KoljaWindeler/CHIP_relay/quotations/quotation_assumtions_v3_20160816jkw.xlsx

Sheet: total
 |  |  |  |  | Customer address | Elecrow address
Vendor:Elecrow |  | Customer: |  |  | Kolja Windeler, Muehlenstr 8a, 29342 Wienhausen, Germany | 5 Floor F1 Building, Fanshen Hua Feng Industrial Park, Hangcheng Road, Gushu, Bao'an District, Shenzhen, 518126 China Tel: +86 0755 36948521
Contact Person:Zeqing |  | Contact Person:
Tel:+86 185 6676 0765 |  | Tel:
Email:Zeqing2012@elecrow.com |  | Email:
Shipping methodDHL |  | Date: 2016/7
If there is any problem, please feel free to contact with me.
For PCB fabricate
Name | layers | dimension | Thickness | surface finished | Solder Mask | Qty | Quotation（$) | weight(g) | Remark
v100_mini | 2 |  | 1.6 | hasl | black | 30 | $27.80
Stencil |  |  |  |  |  |  | $18.00
 |  |  |  |  |  | Total:
For PCB Assembly
Name | Pads | quatity | price | qty of boards | Quotation | Remark
v48 | SMT | 78 | 0.030 | 30 | $125.40 | no discount
 | THT | 46 | 0.040
 |  |  |  | Total:
Engineer Start
Total: | $10.00
Components purchased by Eelcrow |  | Remark
Total: | $44.10 | 30
Shipping
Products | Shipping Method | Weight | Quotation | Remark
PCBAs | DHL | 1kg | $29.00
 |  | Total:
 |  |  |  |  | Total Quatation($): | 8.5 | per board
 |  |  |  |  |  | 254.3 | 30

Sheet: V48
Bill of Material from queso_dip_v4_8.sch, 50 parts, grouped by values, as of 2016/7/13 16:06:16
Part | Value | Device | Package | Description | unit price | total | unit smd | total smd | unit tht | total tht | Qty
R11 | 10k | R-EU_R0805 | R0805 | RESISTOR, European symbol | 0.01 | 0.01 | 2 | 2 | 0 | 0 | 1
R7 | 120R | R-EU_R0805 | R0805 | RESISTOR, European symbol | 0.01 | 0.01 | 2 | 2 | 0 | 0 | 1
POW | 150080BS75000 | LEDCHIP-LED0805 | CHIP-LED0805 | LED |  | 0 | 2 | 2 | 0 | 0 | 1
R1 | 2.2k | R-EU_R0805 | R0805 | RESISTOR, European symbol | 0.01 | 0.01 | 2 | 2 | 0 | 0 | 1
R2, R3, R4, R5 | 200R | R-EU_R0805 | R0805 | RESISTOR, European symbol | 0.01 | 0.04 | 2 | 8 | 0 | 0 | 4
JP1, JP2, JP3 | 571-4-103321-5 | MA03-1 | MA03-1 | PIN HEADER |  | 0 | 0 | 0 | 3 | 9 | 3
SV3 | 571-4-146262-1 | MA03-2 | MA03-2 | PIN HEADER |  | 0 | 0 | 0 | 6 | 6 | 1
SV4 | 649-68000-408HLF | MA08-1 | MA08-1 | PIN HEADER |  | 0 | 0 | 0 | 8 | 8 | 1
P1, P2, P3, P4 | 696-SML-0805ICTR | LEDCHIP-LED0805 | CHIP-LED0805 | LED |  | 0 | 2 | 8 | 0 | 0 | 4
IC1 | 74HCT04D | 74HCT04D | SO14 | Hex INVERTER |  | 0 | 14 | 14 | 0 | 0 | 1
B1 | DBLS202G | DBLS202G | DBS | Single Phase 1.0 AMP Glass Passivated Bridge Rectifier |  | 0 | 4 | 4 | 0 | 0 | 1
U$3, U$7, U$9, U$12 | DMN6068SE-13 | NMOSFET_SMD_223 | SOT223 |  |  | 0 | 4 | 16 | 0 | 0 | 4
U1 | DS2431P+T&R | DS2431P | TSOC6 | 1024-Bit EEPROM |  | 0 | 6 | 6 | 0 | 0 | 1
C2, C4, C5 | EMZR500ADA221MHA0G | CPOL-US150CLZ-0810 | 150CLZ-0810 | POLARIZED CAPACITOR, American symbol |  | 0 | 2 | 6 | 0 | 0 | 3
D1, D2, D3, D4 | ES2D | DIODE-SMB | SMB | DIODE | 0.35 | 1.4 | 2 | 8 | 0 | 0 | 4
U$10 | R-7805-1.0 | R-7805-1.0 | SIP3 |  |  | 0 | 0 | 0 | 3 | 3 | 1
U$1, U$2, U$8, U$11 | SRD-05VDC-SL-C | RELAYPTH | SRD-05VDC-SL-C | SPDT relay (COM-00101) |  | 0 | 0 | 0 | 5 | 20 | 4
R6, R8, R9, R10 | n.a. (10k) | R-EU_R0805 | R0805 | RESISTOR, European symbol
 |  |  |  |  | total | 1.47 |  | 78 |  | 46
 |  |  |  |  | ordered like this before or confirmed
 |  |  |  |  | never order, price check
 |  |  |  |  | do not assemble

Sheet: Sheet1
Parts | Value | Device | Package | Description | Qty | DESCRIPTION | FOOTPRINT | LINK | MF | MFG | MFG_PN | MPN | OC_FARNELL | OC_NEWARK | PART_TYPE | PRICE | PROD_ID | TOLLERANCE | VENDOR | VENDOR_PART_NUMBER
R11 | 10k | R-EU_R0805 | R0805 | RESISTOR, European symbol | 1
R7 | 120R | R-EU_R0805 | R0805 | RESISTOR, European symbol | 1
POW | 150080BS75000 | LEDCHIP-LED0805 | CHIP-LED0805 | LED | 1
R1 | 2.2k | R-EU_R0805 | R0805 | RESISTOR, European symbol | 1
R2, R3, R4, R5 | 200R | R-EU_R0805 | R0805 | RESISTOR, European symbol | 4
JP1, JP2, JP3 | 571-4-103321-5 | MA03-1 | MA03-1 | PIN HEADER | 3 |  |  |  |  |  |  |  | unknown | unknown
SV3 | 571-4-146262-1 | MA03-2 | MA03-2 | PIN HEADER | 1 |  |  |  |  |  |  |  | unknown | unknown
SV4 | 649-68000-408HLF | MA08-1 | MA08-1 | PIN HEADER | 1 |  |  |  |  |  |  |  | unknown | unknown
P1, P2, P3, P4 | 696-SML-0805ICTR | LEDCHIP-LED0805 | CHIP-LED0805 | LED | 4
IC1 | 74HCT04D | 74HCT04D | SO14 | Hex INVERTER | 1
B1 | DBLS202G | DBLS202G | DBS | Single Phase 1.0 AMP Glass Passivated Bridge Rectifier | 1
U$3, U$7, U$9, U$12 | DMN6068SE-13 | NMOSFET_SMD_223 | SOT223 |  | 4
U1 | DS2431P+T&R | DS2431P | TSOC6 | 1024-Bit EEPROM | 1 | IC, 1024-Bit, 1-Wire EEPROM, TSOC6 | TSOC6 | http://www.digikey.com/product-detail/en/DS2431P%2BT%26R/DS2431P%2BT%26RCT-ND/3647900 |  | DIGIKEY | DS2431P+T&RCT-ND |  |  |  | IC | 0.98 |  |  | MAXIM | DS2431P+T&R
C2, C4, C5 | EMZR500ADA221MHA0G | CPOL-US150CLZ-0810 | 150CLZ-0810 | POLARIZED CAPACITOR, American symbol | 3
D1, D2, D3, D4 | ES2D | DIODE-SMB | SMB | DIODE | 4
U$10 | R-7805-1.0 | R-7805-1.0 | SIP3 |  | 1
U$1, U$2, U$8, U$11 | SRD-05VDC-SL-C | RELAYPTH | SRD-05VDC-SL-C | SPDT relay (COM-00101) | 4
