KoljaWindeler/CHIP_relay/schematics/v3/relay_dip_v03.brd

## EAGLE design schematics/v3/relay_dip_v03.brd (2017-02-10)

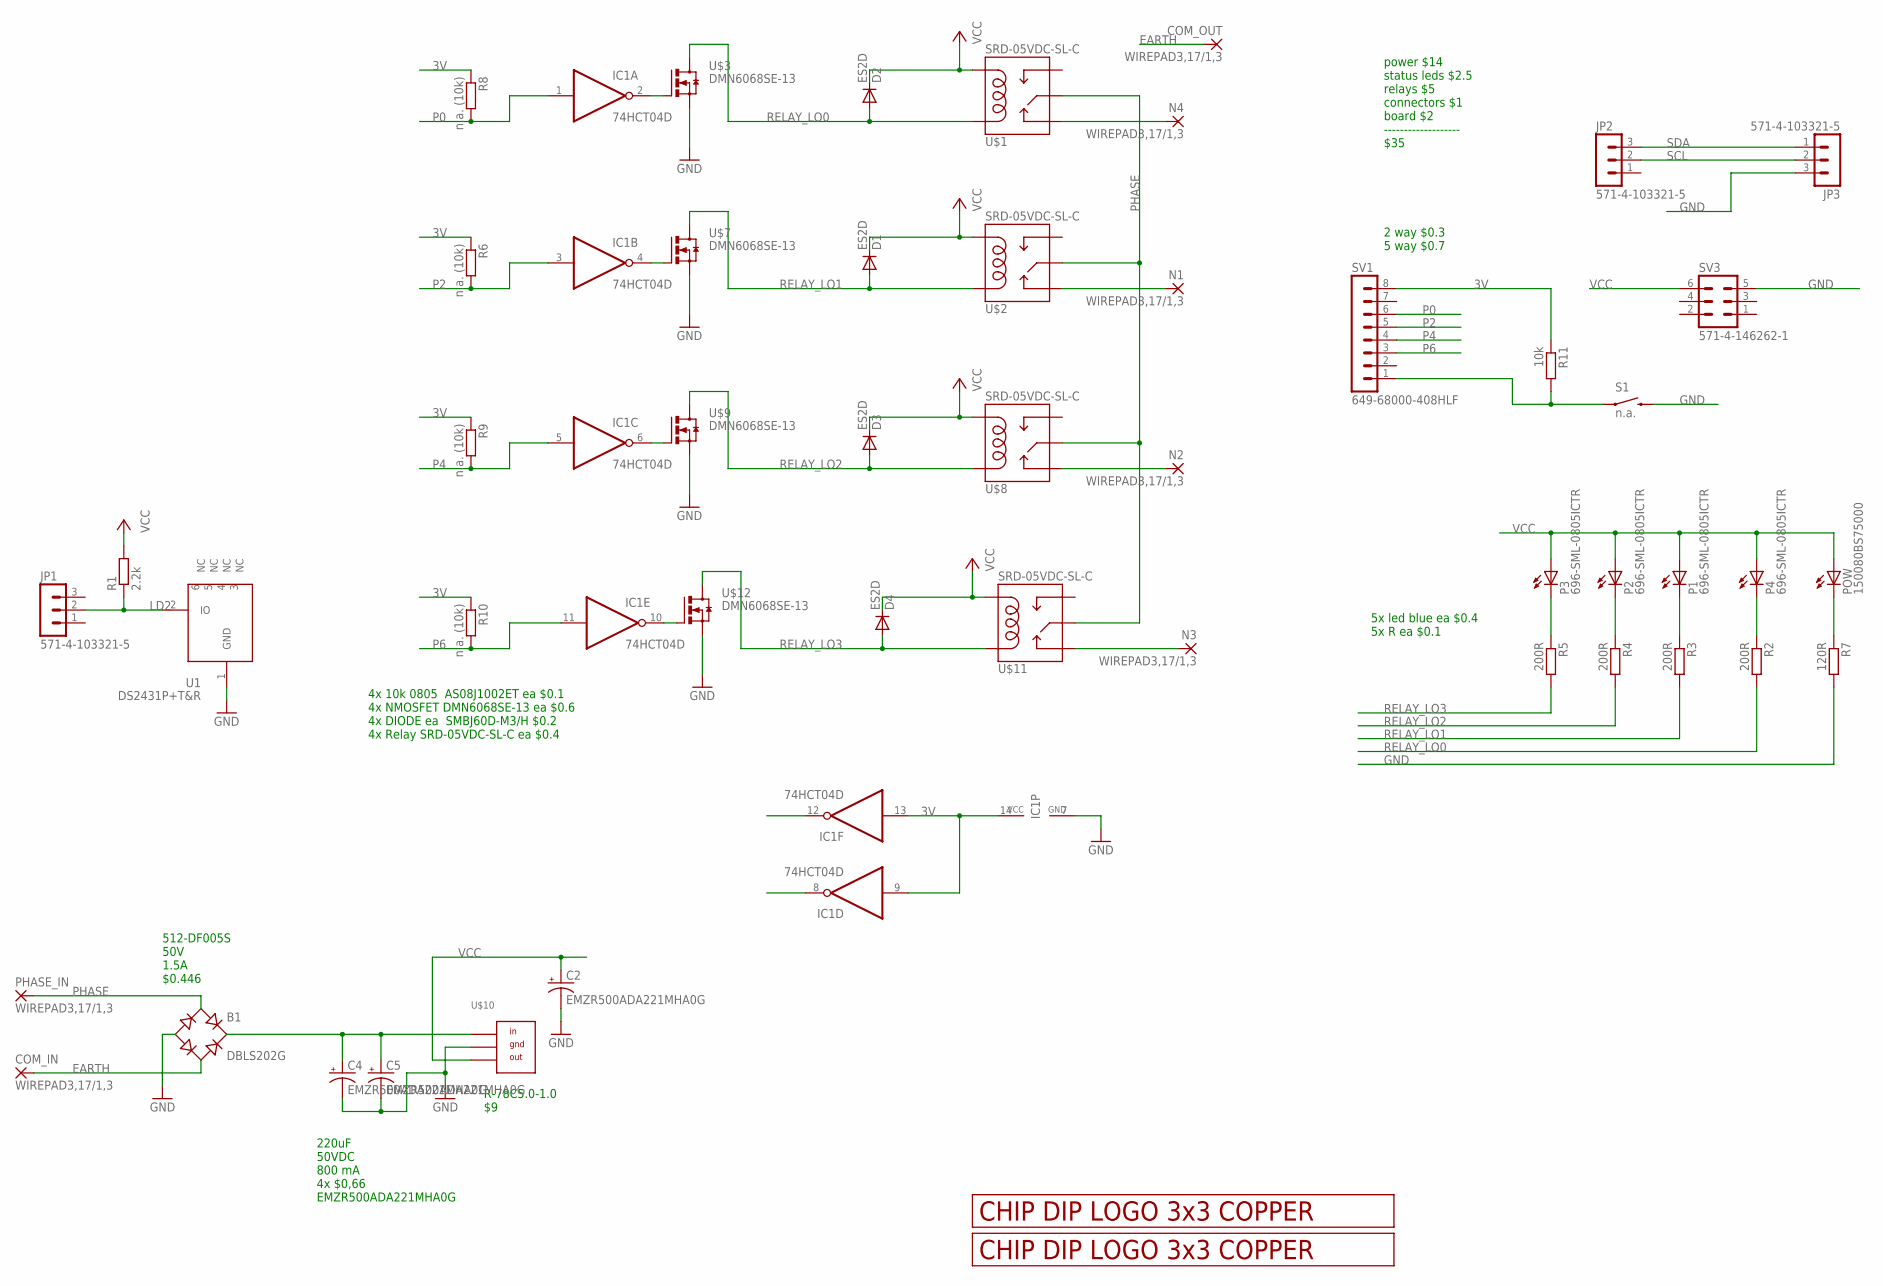
[picture p1: schematic relay_dip_v03.sch]

Parts:
B1: DBLS202G; DBS
C2, C4, C5: EMZR500ADA221MHA0G; 150CLZ-0810
COM_IN: WIREPAD3,17/1,3; 3,17/1,3
COM_OUT: WIREPAD3,17/1,3; 3,17/1,3
D1, D2, D3, D4: ES2D; SMB
IC1: 74HCT04D; SO14
JP1, JP2, JP3: 571-4-103321-5; MA03-1
N1, N2, N3, N4: WIREPAD3,17/1,3; 3,17/1,3
P1, P2, P3, P4: 696-SML-0805ICTR; CHIP-LED0805
PHASE_IN: WIREPAD3,17/1,3; 3,17/1,3
POW: 150080BS75000; CHIP-LED0805
R1: 2.2k; R0805
R2, R3, R4, R5: 200R; R0805
R6, R8, R9, R10: n.a. (10k); R0805
R7: 120R; R0805
R11: 10k; R0805
S1: n.a.; TACTILE-SWITCH-SMD
SV1: 649-68000-408HLF; MA08-1
SV3: 571-4-146262-1; MA03-2
U1: DS2431P+T&R; TSOC6
U$1, U$2, U$8, U$11: SRD-05VDC-SL-C
U$3, U$7, U$9, U$12: DMN6068SE-13; SOT223
U$4, U$6: LOGO_3X3_COPPER
U$10: R-7805-1.0; SIP3

Connections:
3V: IC1.9 (I), IC1.13 (I), IC1.14 (VCC), R6.1, R8.1, R9.1, R10.1, R11.1, SV1.8
EARTH: B1.AC2, COM_IN.1, COM_OUT.1
GND: B1.-, C2.-, C4.-, C5.-, IC1.7 (GND), JP3.3, R7.2, S1.3 (2), SV3.5, U1.1 (GND), U$3.3 (S), U$7.3 (S), U$9.3 (S), U$10.GND, U$12.3 (S)
LD2: JP1.2, R1.1, U1.2 (IO)
unnamed: R11.2, S1.1, SV1.1
unnamed: IC1.2 (O), U$3.1 (G)
unnamed: P4.C, R2.1
unnamed: P1.C, R3.1
unnamed: B1.+, C4.+, C5.+, U$10.IN
unnamed: IC1.4 (O), U$7.1 (G)
unnamed: P2.C, R4.1
unnamed: IC1.6 (O), U$9.1 (G)
unnamed: P3.C, R5.1
unnamed: IC1.10 (O), U$12.1 (G)
unnamed: POW.C, R7.1
NCL: N4.1, U$1.SWCLOSED (SWCLOSE)
NCL1: N1.1, U$2.SWCLOSED (SWCLOSE)
NCL2: N2.1, U$8.SWCLOSED (SWCLOSE)
NCL3: N3.1, U$11.SWCLOSED (SWCLOSE)
P0: IC1.1 (I), R8.2, SV1.6
P2: IC1.3 (I), R6.2, SV1.5
P4: IC1.5 (I), R9.2, SV1.4
P6: IC1.11 (I), R10.2, SV1.3
PHASE: B1.AC1, PHASE_IN.1, U$1.SWCOMMON, U$2.SWCOMMON, U$8.SWCOMMON, U$11.SWCOMMON
RELAY_LO0: D2.A, R2.2, U$1.COIL1, U$3.2 (D), U$3.4 (D)
RELAY_LO1: D1.A, R3.2, U$2.COIL1, U$7.2 (D), U$7.4 (D)
RELAY_LO2: D3.A, R4.2, U$8.COIL1, U$9.2 (D), U$9.4 (D)
RELAY_LO3: D4.A, R5.2, U$11.COIL1, U$12.2 (D), U$12.4 (D)
SCL: JP2.2, JP3.2
SDA: JP2.3, JP3.1
VCC: C2.+, D1.C, D2.C, D3.C, D4.C, P1.A, P2.A, P3.A, P4.A, POW.A, R1.2, SV3.6, U$1.COIL0, U$2.COIL0, U$8.COIL0, U$10.OUT, U$11.COIL0

Notes on the sheet:
220uF 50VDC 800 mA 4x $0,66 EMZR500ADA221MHA0G
512-DF005S 50V 1.5A $0.446
R-78C5.0-1.0 $9
4x 10k 0805 AS08J1002ET ea $0.1 4x NMOSFET DMN6068SE-13 ea $0.6 4x DIODE ea SMBJ60D-M3/H $0.2 4x Relay SRD-05VDC-SL-C ea $0.4
2 way $0.3 5 way $0.7
5x led blue ea $0.4 5x R ea $0.1
power $14 status leds $2.5 relays $5 connectors $1 board $2 ------------------- $35

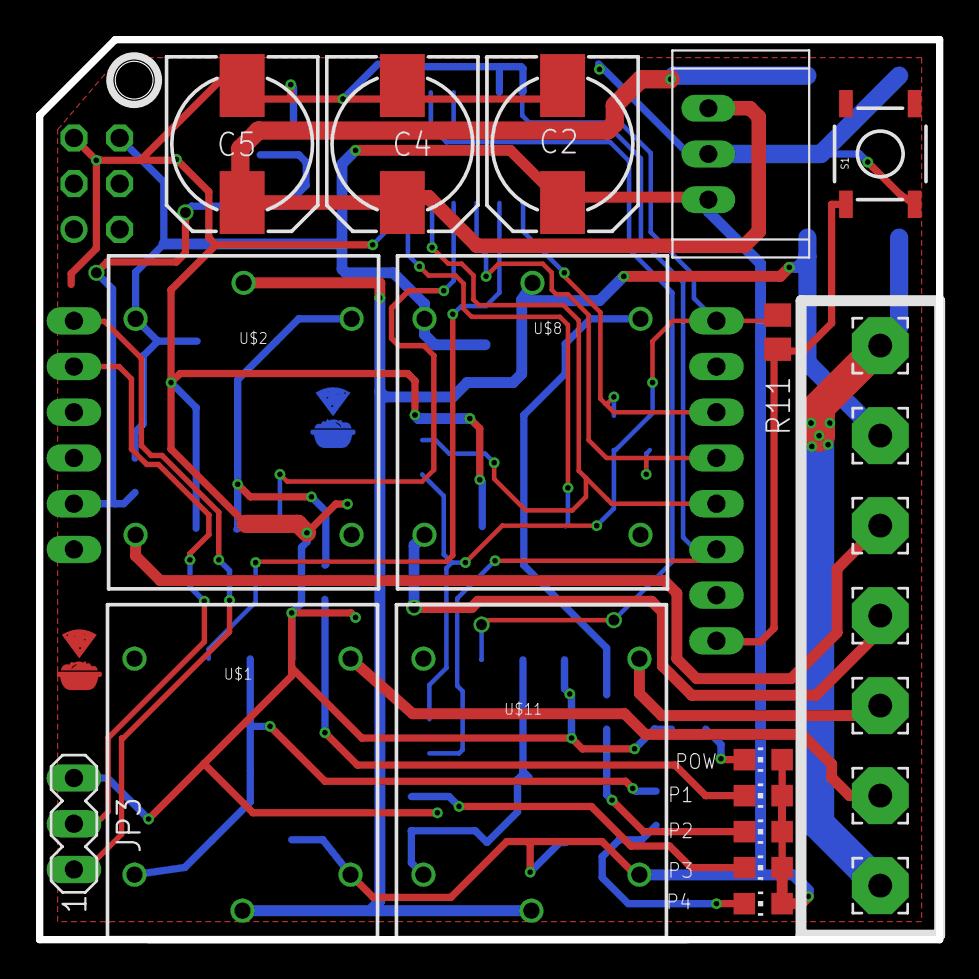
[picture p2: board relay_dip_v03.brd from above]

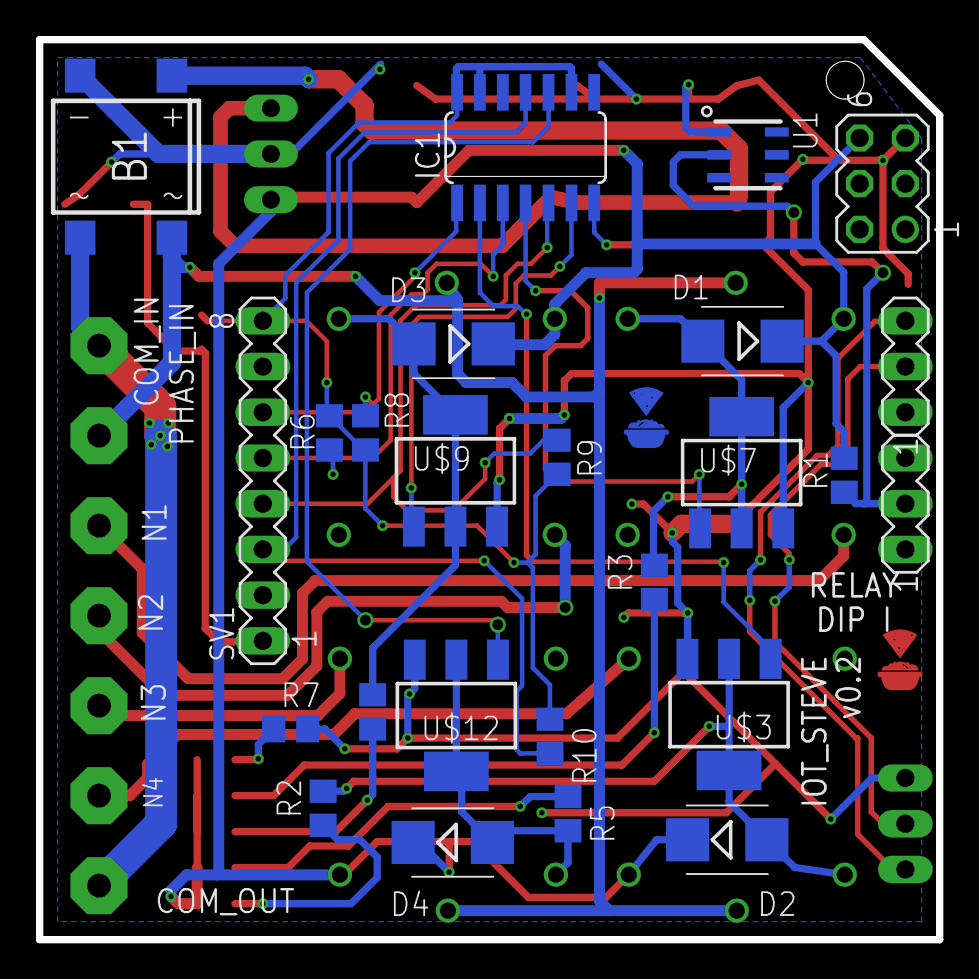
[picture p3: board relay_dip_v03.brd from below]

Board: 2 copper layers, 50.0 x 50.0 mm, 50 parts (26 on the bottom side), 31 nets.
