KoljaWindeler/CHIP_relay/(commit log)

2016-06-16 moved files to subfolder
    [relay_dip_v01.GBL, relay_dip_v01.GBO, relay_dip_v01.GBP, relay_dip_v01.GBS, relay_dip_v01.GTL, relay_dip_v01.GTO, relay_dip_v01.GTP, relay_dip_v01.GTS]
2016-07-18 moved v2 to dedicated folder, ordered boards
    [relay_dip_v02.GBL, relay_dip_v02.GBO, relay_dip_v02.GBP, relay_dip_v02.GBS, relay_dip_v02.GTL, relay_dip_v02.GTO, relay_dip_v02.GTP, relay_dip_v02.GTS]
2016-07-19 ordered design
    [relay_dip_v02.GBL, relay_dip_v02.GBO, relay_dip_v02.GBP, relay_dip_v02.GBS, relay_dip_v02.GTL, relay_dip_v02.GTO, relay_dip_v02.GTP, relay_dip_v02.GTS]
2016-08-02 added v3, fixed ds2431 footprint, added quotation
    [quotation_assumtions_v1.xlsx, relay_dip_v02.brd, relay_dip_v02.sch, relay_dip_v03.brd, relay_dip_v03.csv, relay_dip_v03.sch]
2016-08-16 updated quotiation, bom and ger
    [bom_v3_20160816jkw.csv, quotation_assumtions_v1.xlsx, quotation_assumtions_v3_20160816jkw.xlsx, relay_dip_v03.csv]
2016-09-18 moved relays apart
    [relay_dip_v03.brd]
2016-09-20 flipped pin header to lower layer
    [relay_dip_v03.brd, relay_dip_v03.sch]
2016-10-11 moved switch further outside
    [relay_dip_v03.brd]
2017-02-10 added designators
    [relay_dip_v03.brd, relay_dip_v03.sch]
